mmartinbr/coil-winder/images-videos/coil-winder/IMG_20200219_183628.jpg

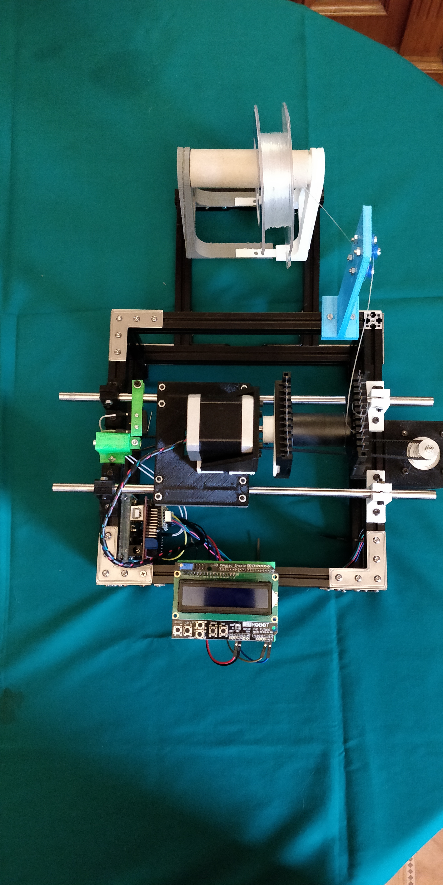
images-videos/coil-winder/IMG_20200219_183628.jpg
