mmartinbr/coil-winder/images-videos/coil-winder/IMG_20200219_183638.jpg

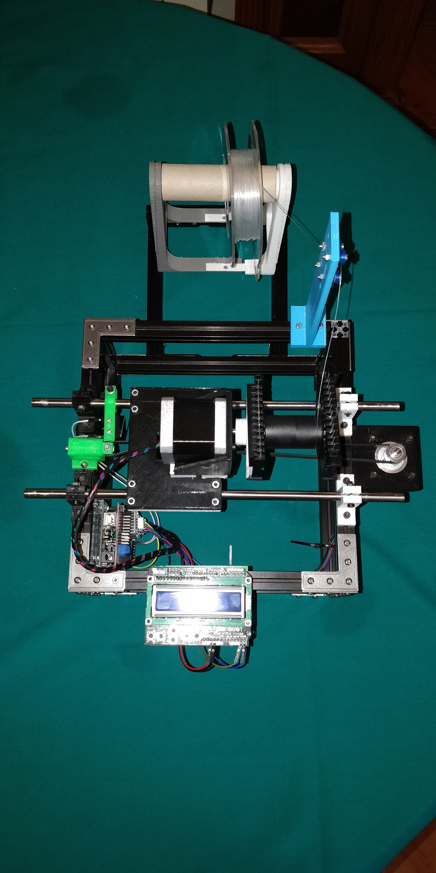
images-videos/coil-winder/IMG_20200219_183638.jpg
