mmartinbr/coil-winder/images-videos/coil-winder/IMG_20200219_184023.jpg

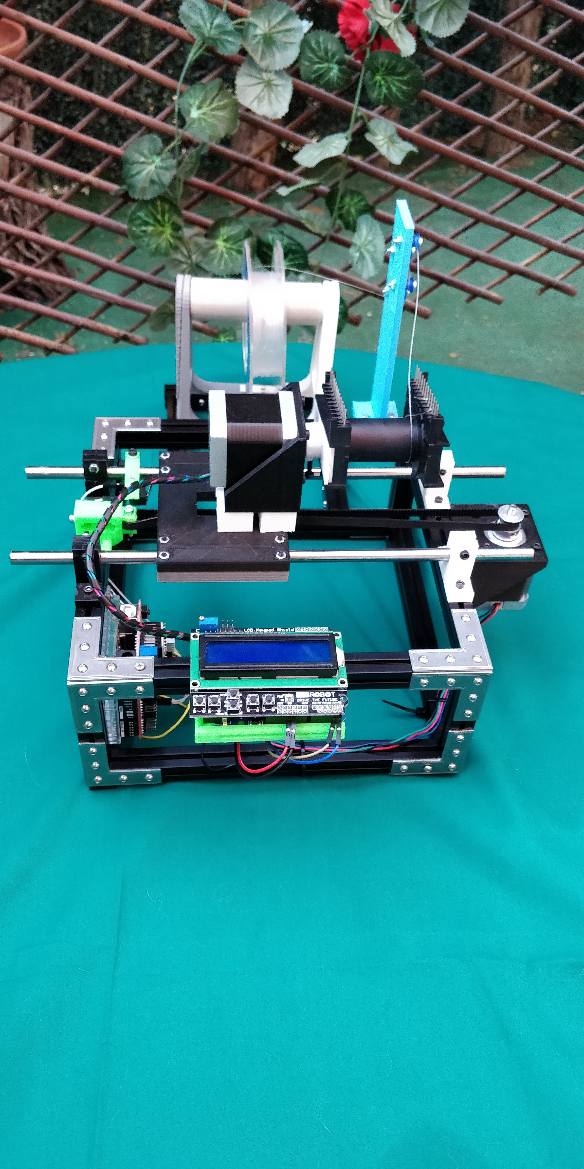
images-videos/coil-winder/IMG_20200219_184023.jpg
