mmartinbr/coil-winder/images-videos/coil-winder/IMG_20200219_184037.jpg

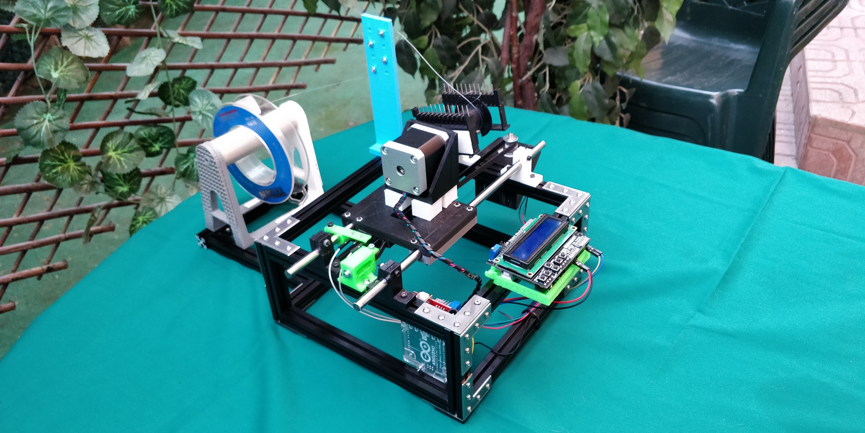
images-videos/coil-winder/IMG_20200219_184037.jpg
