mmartinbr/coil-winder/images-videos/coil-winder/IMG_20200219_184148.jpg

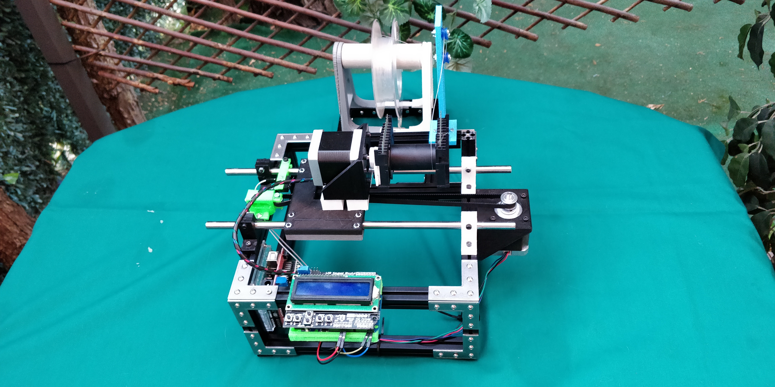
images-videos/coil-winder/IMG_20200219_184148.jpg
