mmartinbr/coil-winder/images-videos/i2c-communication/IMG_20200202_224621.jpg

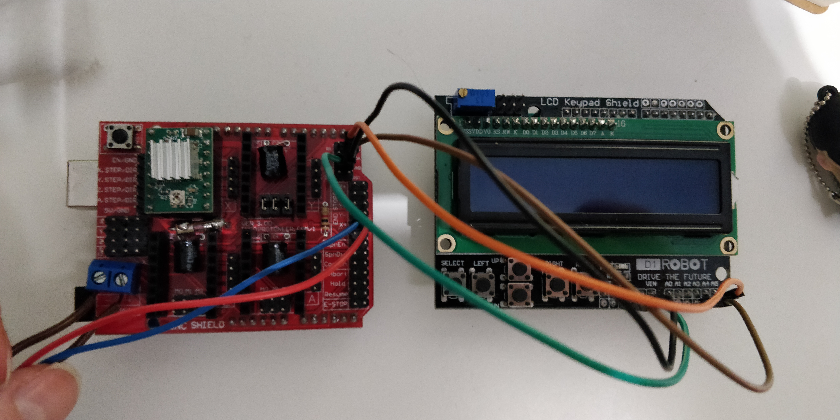
images-videos/i2c-communication/IMG_20200202_224621.jpg
