mmartinbr/coil-winder/images-videos/IMG_20200218_215349.jpg

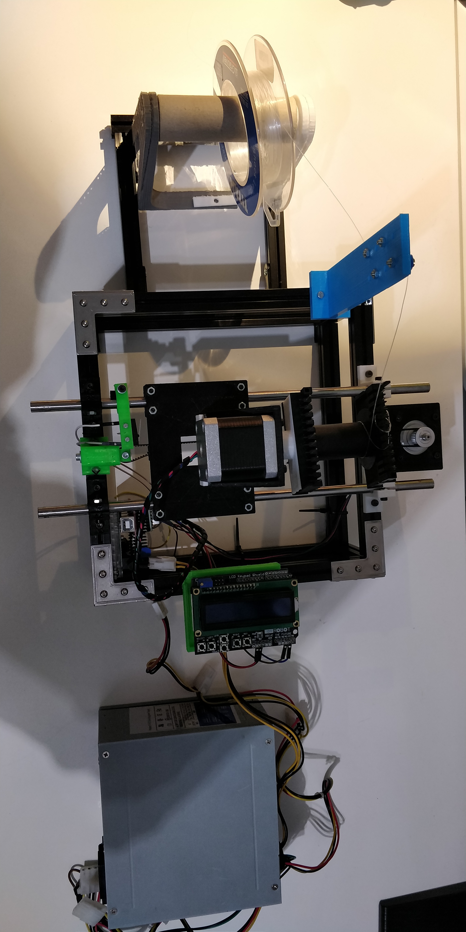
images-videos/IMG_20200218_215349.jpg
