mmartinbr/coil-winder/images-videos/IMG_20200218_215355.jpg

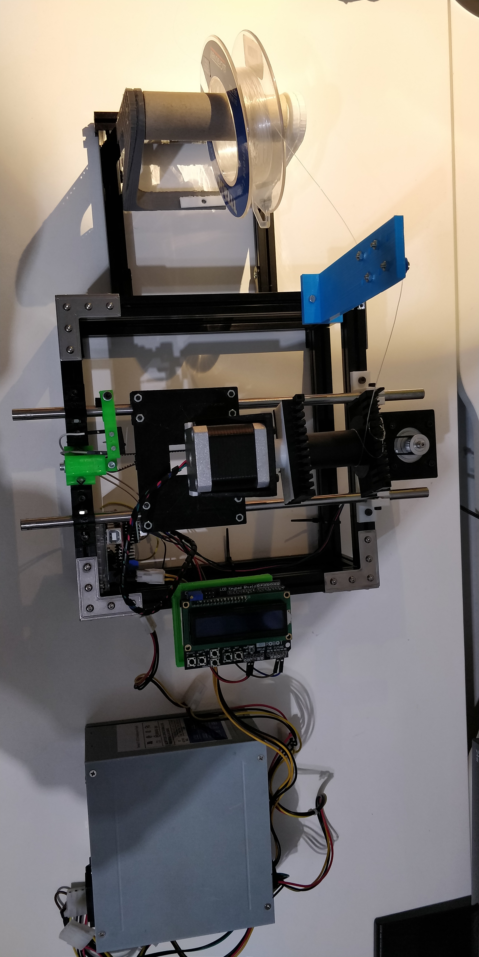
images-videos/IMG_20200218_215355.jpg
