mmartinbr/coil-winder/images-videos/IMG_20200218_215358.jpg

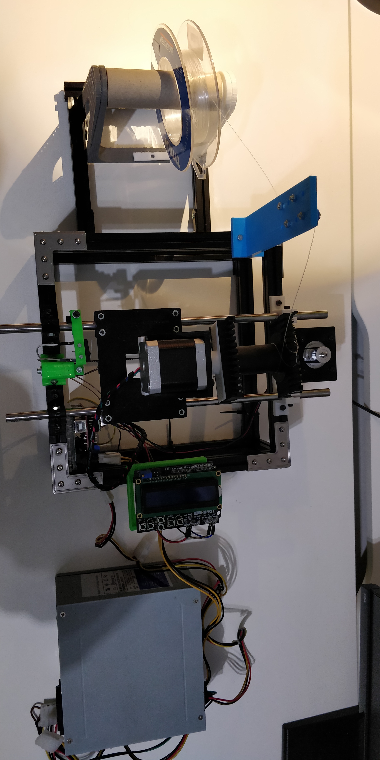
images-videos/IMG_20200218_215358.jpg
