mmartinbr/coil-winder/images-videos/IMG_20200218_215542.jpg

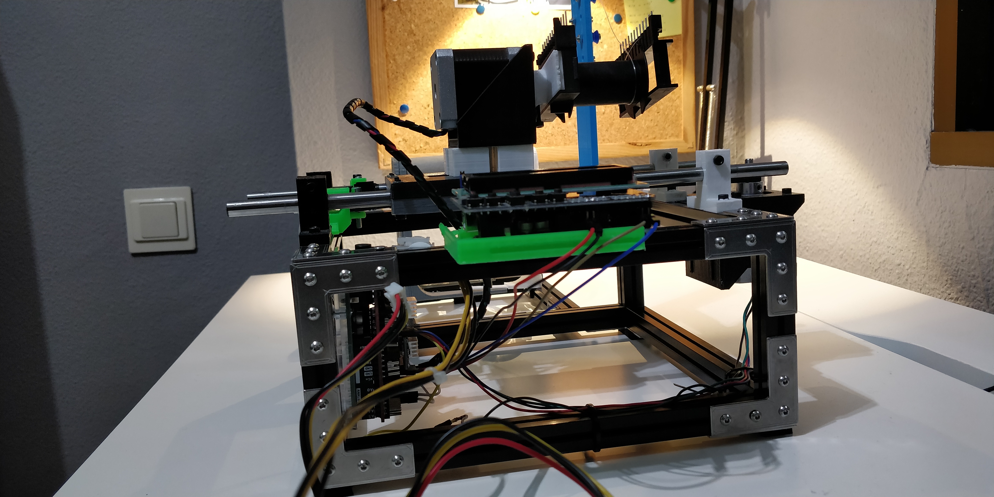
images-videos/IMG_20200218_215542.jpg
