mmartinbr/coil-winder/images-videos/IMG_20200218_215630.jpg

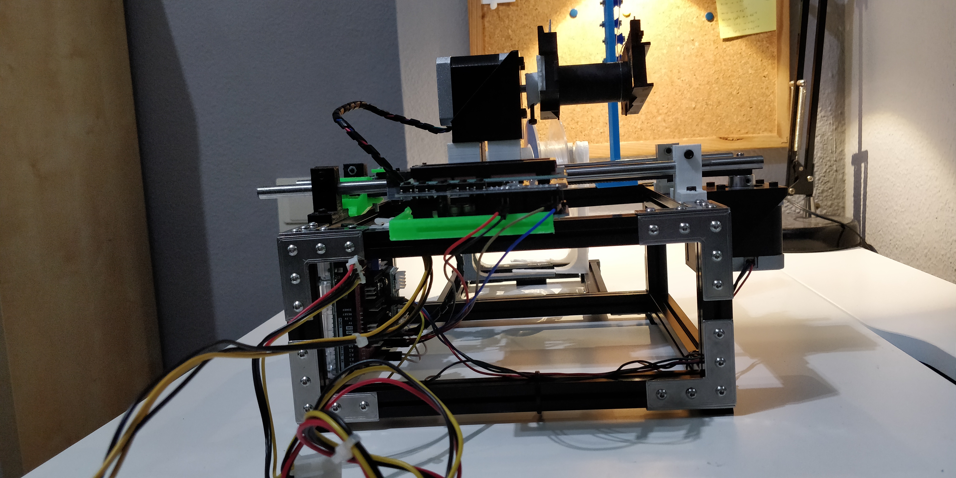
images-videos/IMG_20200218_215630.jpg
