mmartinbr/coil-winder/images-videos/IMG_20200218_215646.jpg

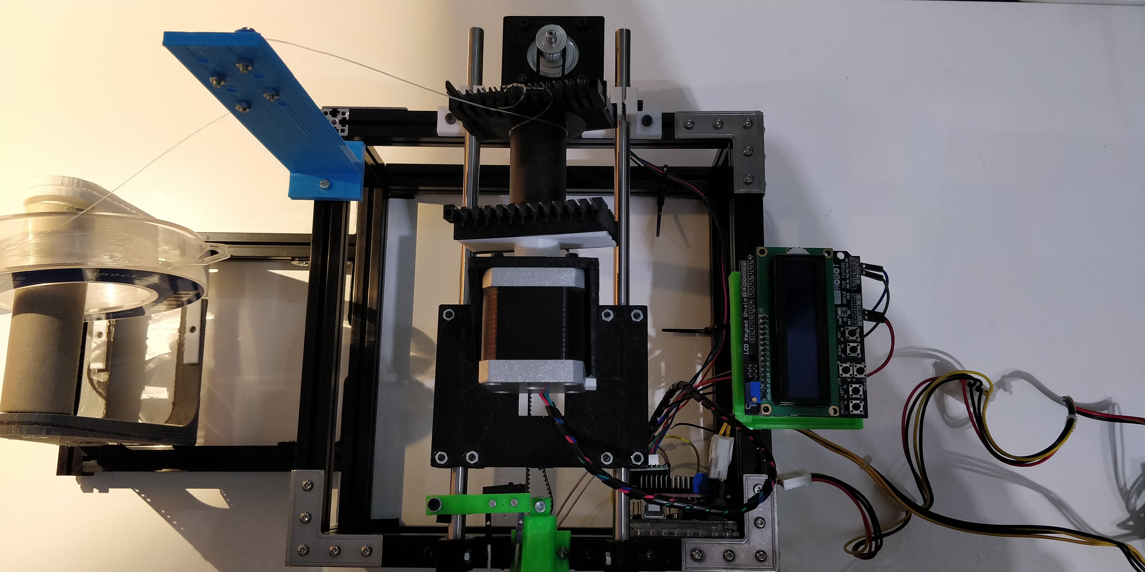
images-videos/IMG_20200218_215646.jpg
