mmartinbr/coil-winder/images-videos/IMG_20200218_215827.jpg

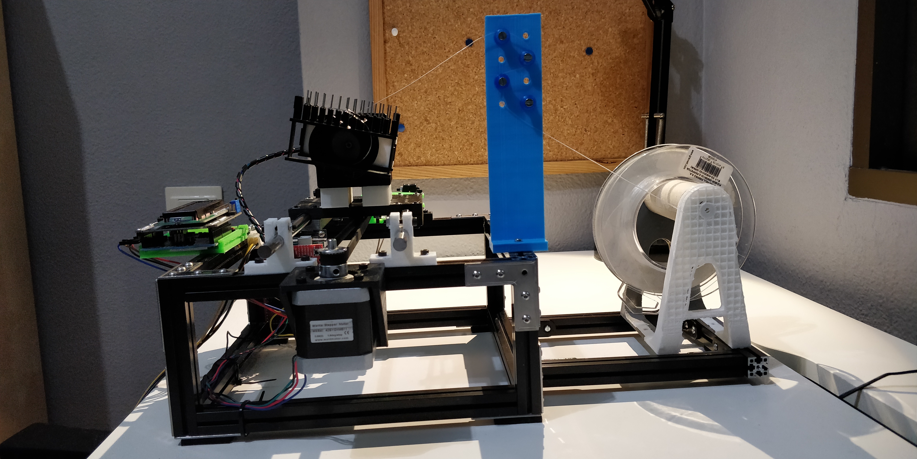
images-videos/IMG_20200218_215827.jpg
