mmartinbr/coil-winder/images-videos/IMG_20200218_215900.jpg

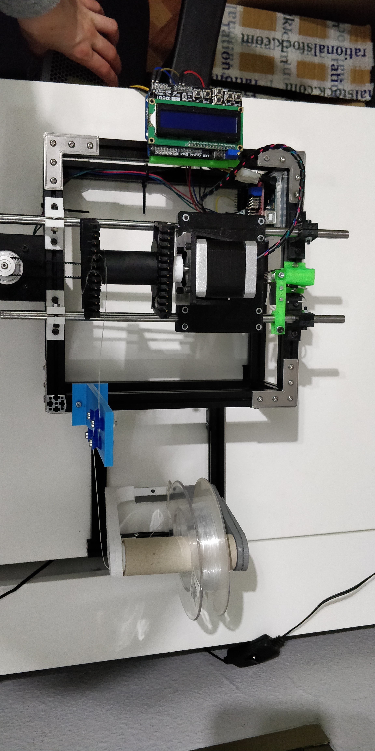
images-videos/IMG_20200218_215900.jpg
