mmartinbr/coil-winder/images-videos/lcd-display/IMG_20200202_213406.jpg

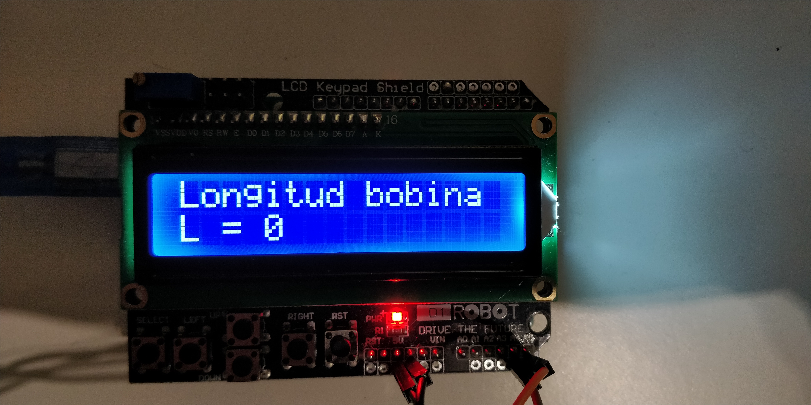
images-videos/lcd-display/IMG_20200202_213406.jpg
