mmartinbr/coil-winder/documentation/components/coil-winder-bom.xlsx

Sheet: Elementos_comprados
Componente | Cantidad | Proveedor | Precio unitario | Precio total | Enlace
Correa dentada GT2 - 6mm - 1m | 1 | HTA3D | 1.37 € | 1.37 € | https://www.hta3d.com/es/correa-dentada-gt2-6mm-1m
Polea GT2 - 20 dientes | 2 | HTA3D | 1.10 € | 2.20 € | https://www.hta3d.com/componentes/mecanica/correas-y-poleas/polea-gt2-20-dientes
Motor paso a paso Nema 17, Serie 17HS 17HS8401 | 2 | HTA3D | 12.85 € | 25.70 € | https://www.hta3d.com/componentes/electronica/motor-paso-a-paso/nema17-motor-paso-a-paso-serie-17hs-motor-paso-a-paso-hibrido-dos-fases
Ejes - Varilla lisa calibrada diámetro 8 | 2 | HTA3D | 2.65 € | 5.30 € | https://www.hta3d.com/componentes/mecanica/movimiento-lineal/varilla-lisa-calibrada-diametro-8-cortada-a-medida
Rodamiento lineal Lm8uu | 4 | HTA3D | 0.58 € | 2.32 € | https://www.hta3d.com/rodamiento-lineal-lm8uu
Placa Arduino UNO | 2 | FARNELL | 19.49 € | 38.98 € | http://es.farnell.com/arduino/a000066/atmega328-arduino-uno-eval-board/dp/2075382?ICID=I-HP-PP-Arduino-A000066
Arduino CNC Shield V3.51 | 1 | 3DSMART | 8.29 € | 8.29 € | http://www.3dsmart.es/impresora-3d/electronica/placa-ramps-14.html
POLOLU A4988 | 2 | ELECTRONICA EMBAJADORES | 7.11 € | 14.22 € | https://www.electronicaembajadores.com/es/Productos/Detalle/LCMM004/modulos-electronicos/modulos-driver-y-o-controladores-de-motores/driver-motores-paso-a-pas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
Carcasa Arduino UNO | 2 | AMAZON | 4.30 € | 8.60 € | https://www.amazon.es/Premium-transparente-carcasa-Leonardo-Ethernet/dp/B078326ZDC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
LCD Keypad Shield | 1 | AMAZON | 9.99 € | 9.99 € | https://www.amazon.es/HALJIA%C2%AE-Display-Keyboard-Arduino-MEGA2560/dp/B06XDNY7FY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
Fuente de alimentación 500W ATX | 1 | AMAZON | 10.70 € | 10.70 € | https://www.amazon.es/Unyka-Fuente-ALIMENTACION-500W-52099/dp/B07JBX6Q7B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
Interruptor final de carrera | 1 | CETRONIC | 5.37 € | 10.74 € | https://www.cetronic.es/sqlcommerce/disenos/plantilla1/seccion/Catalogo.jsp?idIdioma=&idTienda=93&cPath=1160
4 barras de 200mm | 2 | MAKERBEAM | 9.25 € | 18.50 € | https://www.makerbeam.com/200mm-4p-black-makerbeamxl-15mmx15mm.html
4 barras de 100mm | 1 | MAKERBEAM | 5.00 € | 5.00 € | https://www.makerbeam.com/100mm-4p-black-makerbeamxl-15mmx15mm.html
4 barras de 100mm | 1 | MAKERBEAM | 5.00 € | 5.00 € | https://www.makerbeam.com/150mm-4p-clear-makerbeamxl-15mmx15mm.html
100 tornillos, M3, 6mm | 1 | MAKERBEAM | 6.50 € | 6.50 € | https://www.makerbeam.com/openbeam-button-head-socket-bolt-6mm-100p-for-open.html
250 tuercas, M3 | 1 | MAKERBEAM | 4.50 € | 4.50 € | https://www.makerbeam.com/makerbeam-nuts-regular-250p.html
12 Escuadras MakerBeam | 2 | MAKERBEAM | 6.95 € | 13.90 € | https://www.makerbeam.com/makerbeam-right-angle-brackets-12p.html
Filamento PLA | 0.7 | HTA3D | 13.50 € | 9.45 € | https://www.hta3d.com/es/bobina-filamento-pla-3d-1-75mm-1kg
Total |  |  |  | 201.26 €

Sheet: Elementos_impresos_en_3D
Pieza | Unidades
Soporte de la bobina | 1
Carcasas | 2
Soporte de los ejes | 4
Soporte de los motores | 2
Soporte del final de carrera
Soporte de la correa
