mmartinbr/coil-winder/freecad-components/rodamientos-soporte-ejes.FCStd

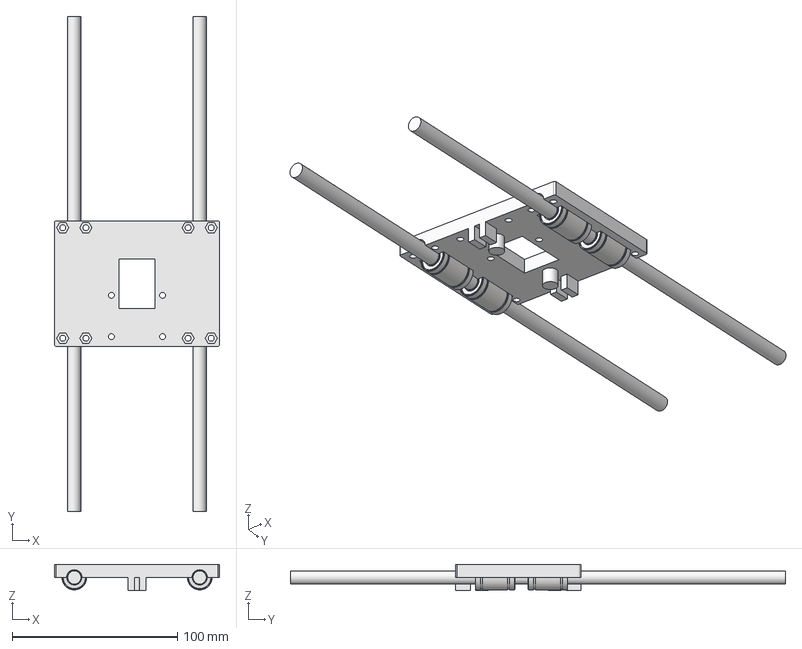
[picture p85: CAD file, 2020-02-20]
freecad-components/rodamientos-soporte-ejes.FCStd
100.0 x 300.0 x 16.0 mm
Lm8uu
Lm8uu001
Lm8uu002
Lm8uu003
Eje1
Eje002
