mmartinbr/coil-winder/freecad-components/tobetested/Cilindros modulo tensionador.FCStd

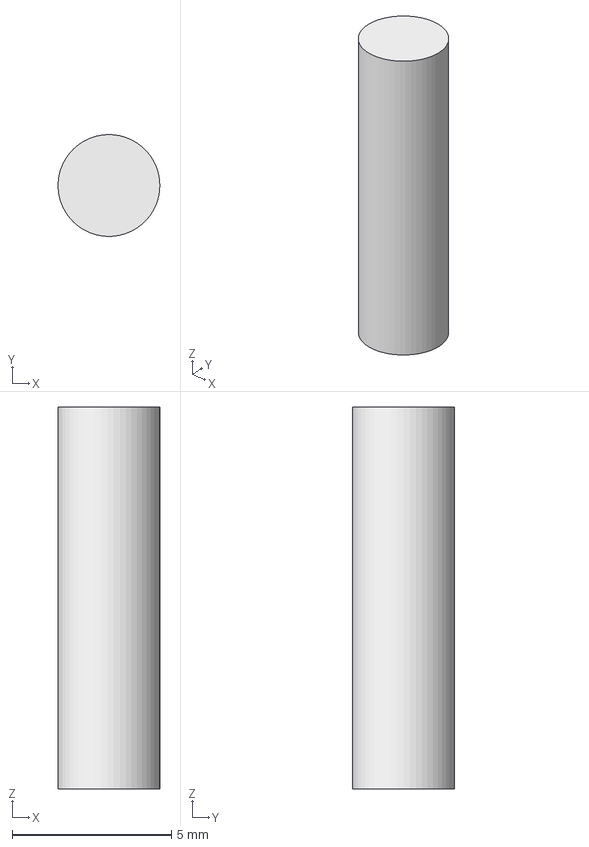
[picture p86: CAD file, 2020-01-19]
freecad-components/tobetested/Cilindros modulo tensionador.FCStd
3.20 x 3.20 x 12.0 mm
