mmartinbr/coil-winder/freecad-components/Soporte bobina-eje_v2.stl

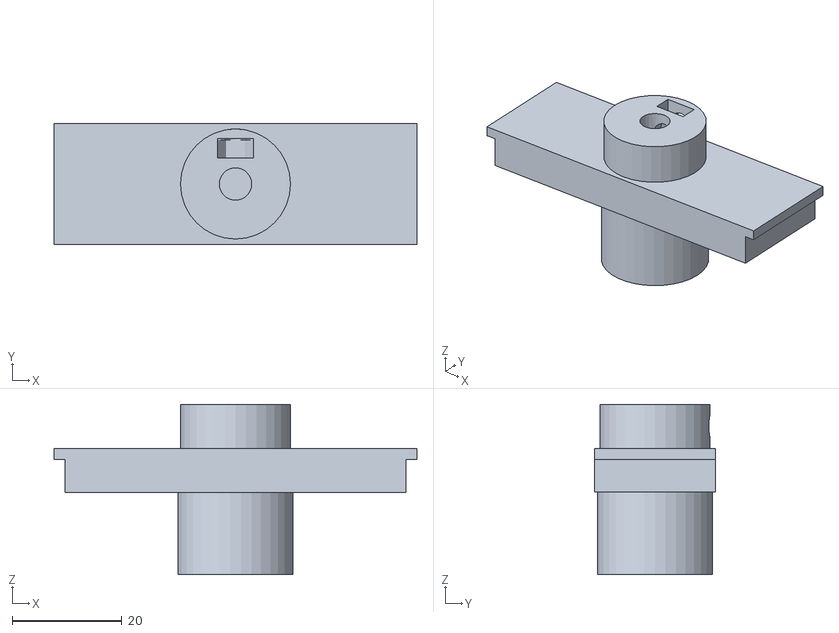
[picture p87: CAD file, 2020-02-18]
freecad-components/Soporte bobina-eje_v2.stl
66.0 x 22.0 x 31.0
