mmartinbr/coil-winder/freecad-components/tobetested/Exterior cilindros modulo tensionador.FCStd

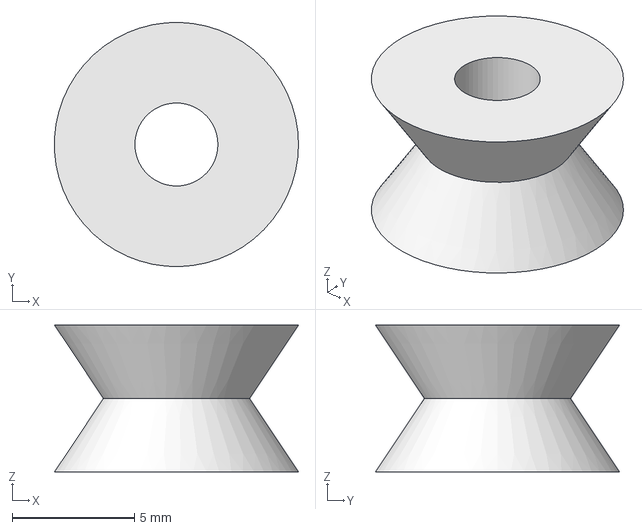
[picture p88: CAD file, 2019-09-13]
freecad-components/tobetested/Exterior cilindros modulo tensionador.FCStd
9.99 x 10.00 x 6.00 mm
