mmartinbr/coil-winder/freecad-components/Soporte bobina-eje.FCStd

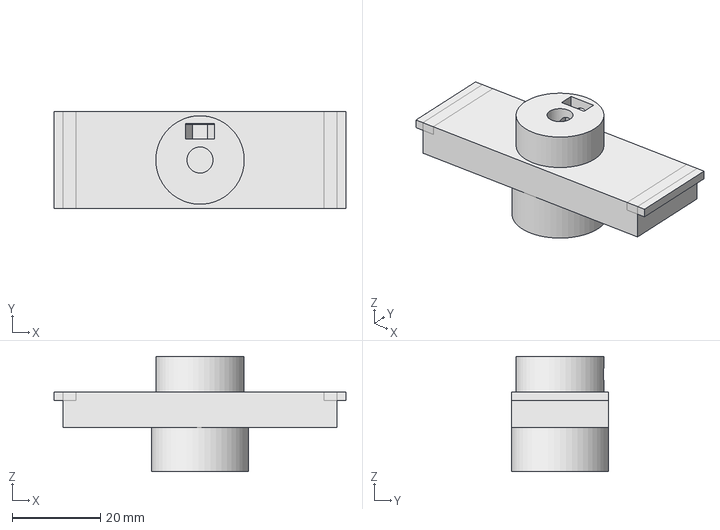
[picture p89: CAD file, 2020-02-18]
freecad-components/Soporte bobina-eje.FCStd
66.0 x 22.0 x 26.0 mm
