mmartinbr/coil-winder/freecad-components/tobetested/Prueba taladro módulo tensionador.FCStd

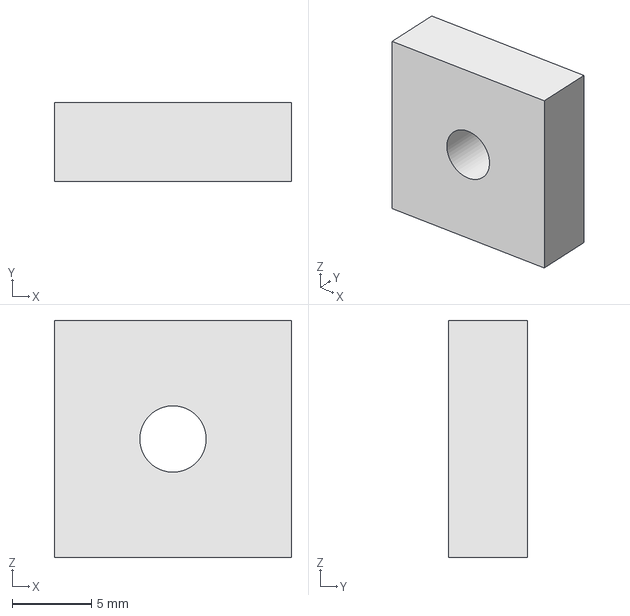
[picture p90: CAD file, 2019-09-10]
freecad-components/tobetested/Prueba taladro módulo tensionador.FCStd
15.0 x 5.00 x 15.0 mm
