mmartinbr/coil-winder/freecad-components/Conjunto módulo tensionador.FCStd

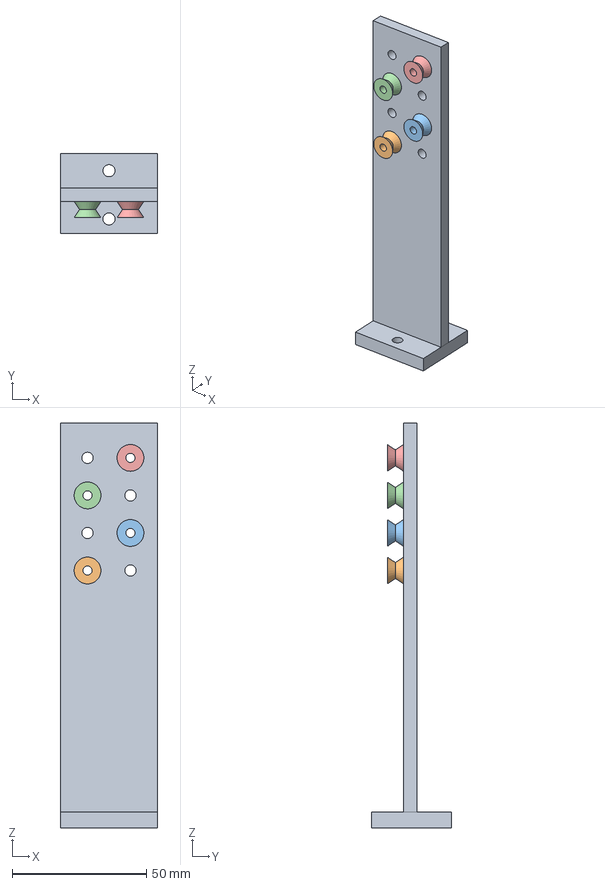
[picture p91: CAD file, 2020-02-01]
freecad-components/Conjunto módulo tensionador.FCStd
36.0 x 30.0 x 151.0 mm
modulo-tensionador2
tensioner
tensioner001
tensioner002
tensioner003
