mmartinbr/coil-winder/freecad-components/modulo_tensionador2.stl

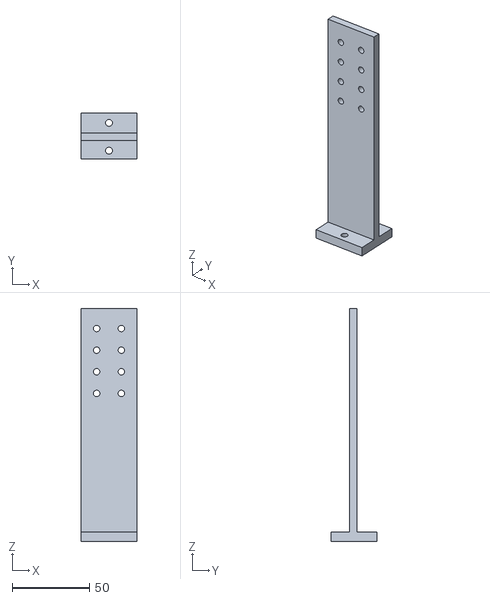
[picture p92: CAD file, 2020-01-19]
freecad-components/modulo_tensionador2.stl
36.0 x 30.0 x 151.0
