mmartinbr/coil-winder/freecad-components/exterior_cilindro2.stl

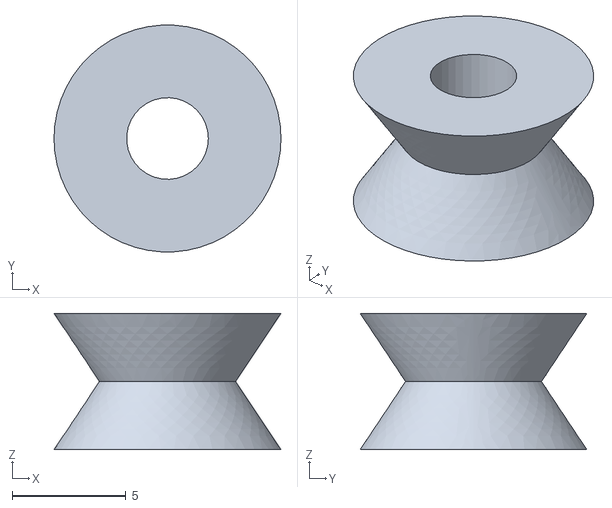
[picture p93: CAD file, 2020-01-19]
freecad-components/exterior_cilindro2.stl
10.0 x 9.98 x 6.00
