mmartinbr/coil-winder/freecad-components/modulo_tensionador.stl

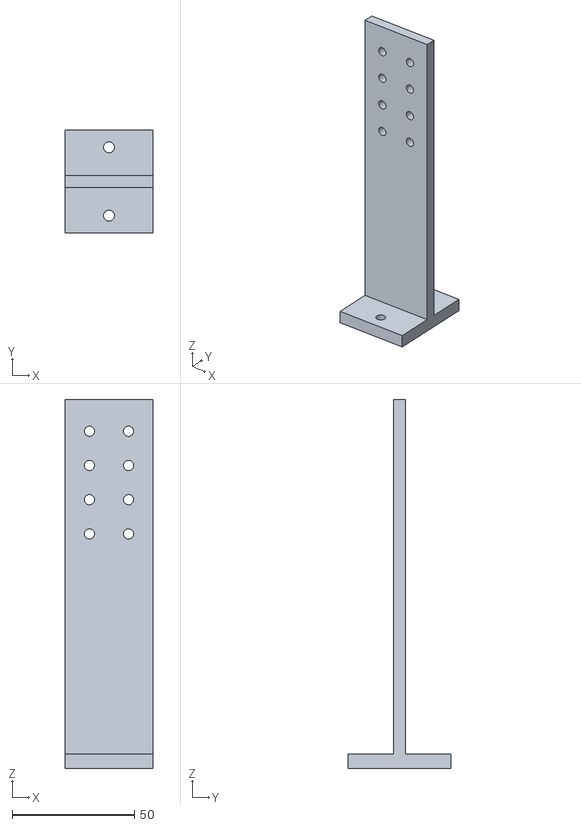
[picture p94: CAD file, 2020-01-19]
freecad-components/modulo_tensionador.stl
36.0 x 42.0 x 151.0
