mmartinbr/coil-winder/freecad-components/Soporte eje Marta.FCStd

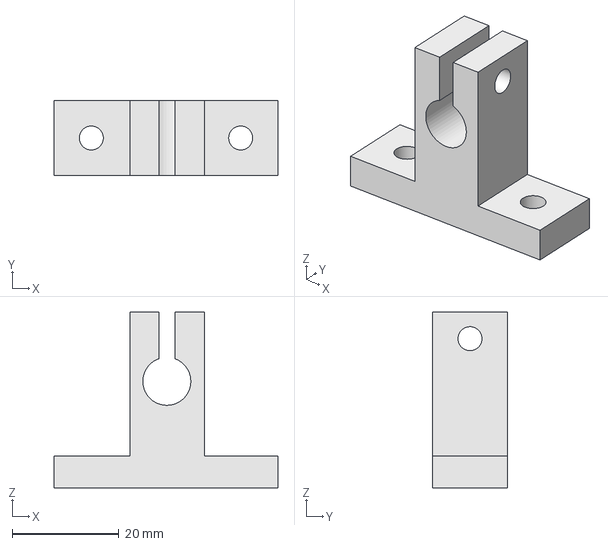
[picture p95: CAD file, 2019-09-10]
freecad-components/Soporte eje Marta.FCStd
42.0 x 14.0 x 33.0 mm
