mmartinbr/coil-winder/freecad-components/Tacos alza.FCStd

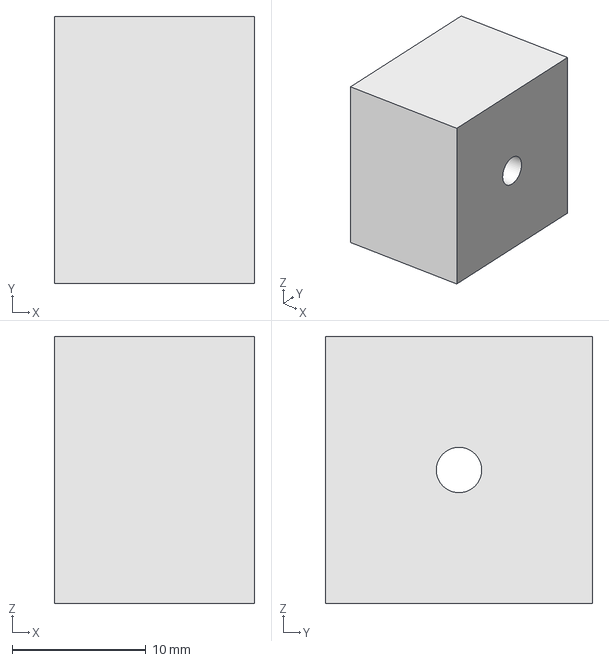
[picture p96: CAD file, 2019-09-10]
freecad-components/Tacos alza.FCStd
15.0 x 20.0 x 20.0 mm
