mmartinbr/coil-winder/freecad-components/Soporte final de carrera.FCStd

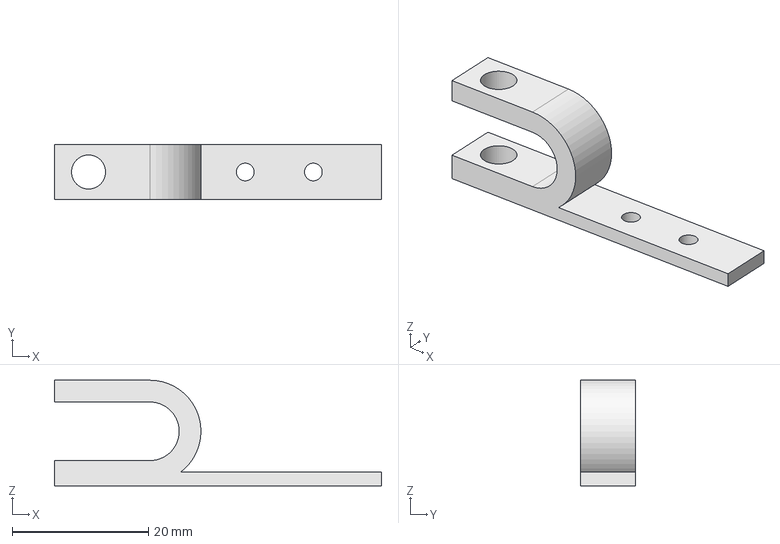
[picture p97: CAD file, 2019-09-10]
freecad-components/Soporte final de carrera.FCStd
48.0 x 8.00 x 15.5 mm
