mmartinbr/coil-winder/freecad-components/Carcasa 2.FCStd

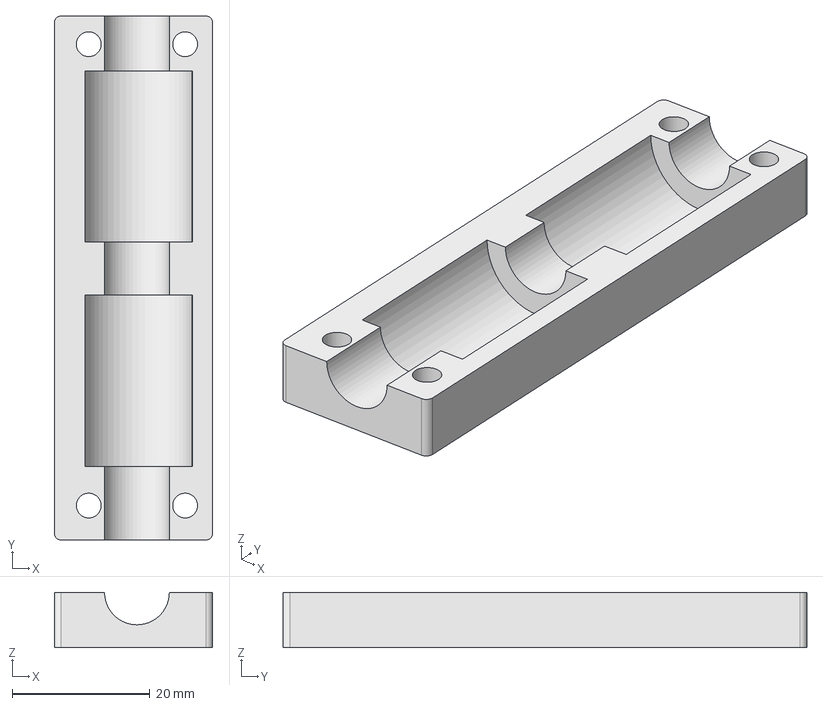
[picture p98: CAD file, 2019-09-10]
freecad-components/Carcasa 2.FCStd
23.0 x 76.1 x 8.00 mm
