mmartinbr/coil-winder/freecad-components/Nema holder.FCStd

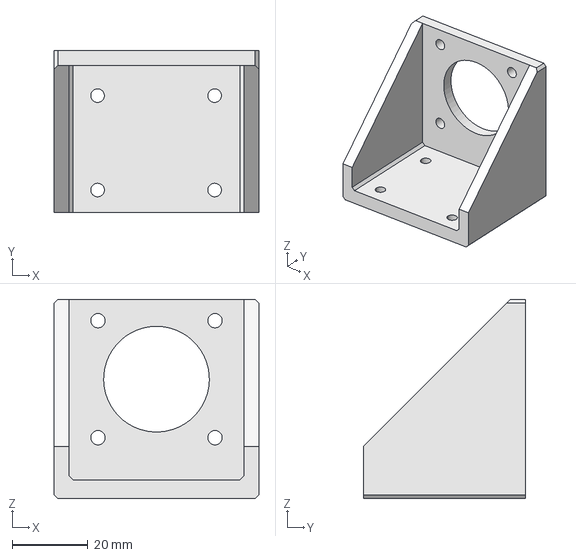
[picture p99: CAD file, 2019-09-10]
freecad-components/Nema holder.FCStd
54.3 x 43.0 x 52.8 mm
