mmartinbr/coil-winder/freecad-components/Coil winder.FCStd

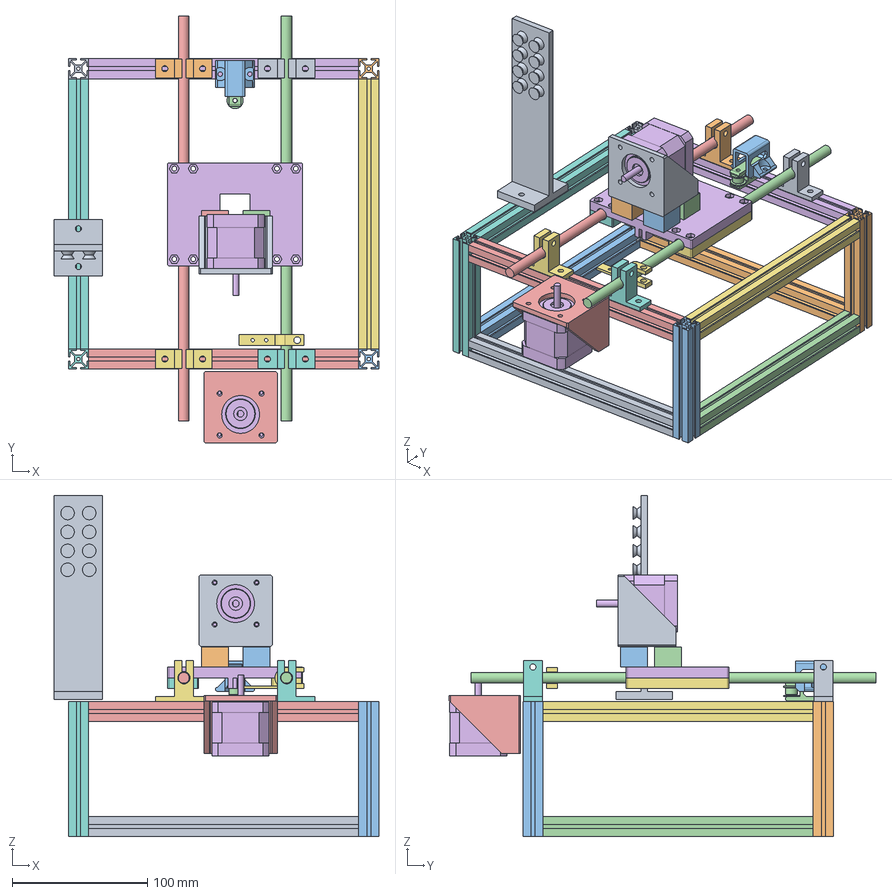
[picture p100: CAD file, 2019-09-10]
freecad-components/Coil winder.FCStd
240.5 x 316.1 x 252.5 mm
aluprof_w15l_200
aluprof_w15l_201
aluprof_w15l_202
aluprof_w15l_203
aluprof_w15l_205
aluprof_w15l_206
aluprof_w15l_204
aluprof_w15l_100
aluprof_w15l_208
aluprof_w15l_209
aluprof_w15l_210
Eje1
Eje002
Soporte principal VII
Carcasa 1 VI
Carcasa 2 VI
nema holder modificados taladros
Nema-17-motor-40mm-final
Soporte eje
Soporte eje001
Soporte eje002
Soporte eje003
tensioner_holder
idler_tensioner_set
nema holder modificados taladros001
Nema-17-motor-40mm-final001
Soporte finalcarrera
aluprof_w15l_207
