mmartinbr/coil-winder/freecad-components/Estructura.FCStd

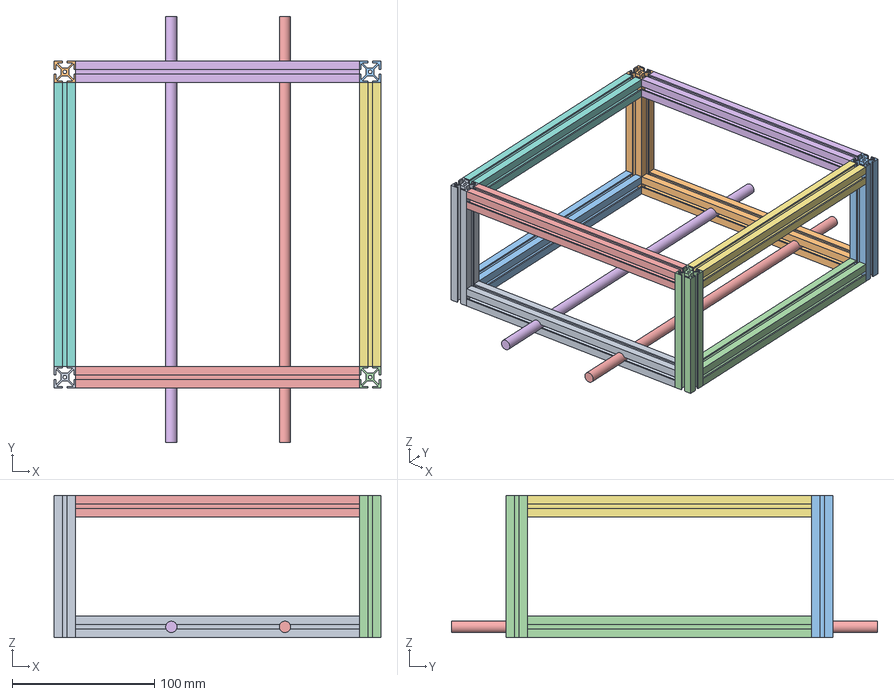
[picture p101: CAD file, 2019-09-10]
freecad-components/Estructura.FCStd
230.0 x 300.0 x 100.0 mm
aluprof_w15l_200
aluprof_w15l_201
aluprof_w15l_202
aluprof_w15l_203
aluprof_w15l_205
aluprof_w15l_206
aluprof_w15l_204
aluprof_w15l_207
aluprof_w15l_100
aluprof_w15l_208
aluprof_w15l_209
aluprof_w15l_210
Eje1
Eje002
