mmartinbr/coil-winder/freecad-components/Soporte principal.FCStd

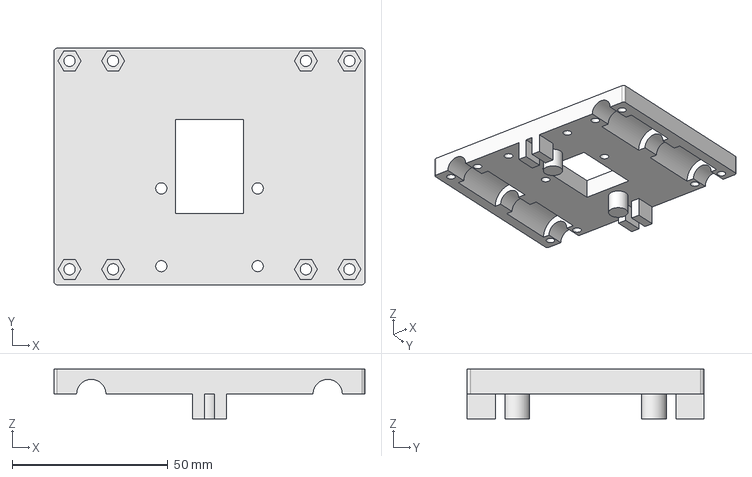
[picture p102: CAD file, 2019-09-10]
freecad-components/Soporte principal.FCStd
100.0 x 76.1 x 16.0 mm
