mmartinbr/coil-winder/(list of files, cad)

Other CAD files:
freecad-components/exterior_cilindros.stl
freecad-components/prueba_taladro.stl
freecad-components/cilindros.stl
freecad-components/Carcasa 1.FCStd
freecad-components/Soporte bobina-eje.stl
