mmartinbr/coil-winder/arduino-code/trials/Coil_winder_sixteenthstep/Coil_winder_sixteenthstep.ino

// Ponemos nombre al motor, el número de pasos y los pins de control
//Stepper stepper(STEPS, 2, 5); //Stepper nombre motor (número de pasos por vuelta, pins de control)
int step_x = 2;
int dir_x = 5;
int enable = 8;
int step_y = 3;
int dir_y = 6;
int endstop_x = 9;
int value = 0;
int t = 0.05;

//Definimos las características del la bobina que queremos devanar:
float L = 40; //Longitud de la bobina a devanar, en mm
float d = 0.5; //Diámetro del hilo de cobre, en mm
int a = L / d; //Nº de vueltas que hay que girar por capa
int o = (16 * d) / 0.2;
int N = 6;


void setup() {

  pinMode(enable, OUTPUT);
  pinMode(dir_x, OUTPUT);
  pinMode(step_x, OUTPUT);
  pinMode(dir_y, OUTPUT);
  pinMode(step_y, OUTPUT);

}

void loop() {

  for (int z = 0; z < a; z++) {

    //Slider de o en o
    for (int k = 1; k < 100; k++) {

      digitalWrite(dir_x, HIGH);
      delay(1); //Pequeña pausa
      digitalWrite(step_x, HIGH);
      delay(0.05); //Pequeña pausa
      digitalWrite(step_x, LOW);
      delay(0.05); //Pequeña pausa
      z = z + 1;

      //Winder de 3200 en 3200 (micro steps *16)
      for (int m = 1; m < 3200; m++) {
        digitalWrite(dir_y, LOW);
        delay(1); //Pequeña pausa
        digitalWrite(step_y, HIGH);
        delay(t); //Pequeña pausa
        digitalWrite(step_y, LOW);
        delay(t); //Pequeña pausa
      }
    }
  }
}
