mmartinbr/coil-winder/(commit log)

2019-09-10 added new files to the project
    [Carcasa 1.FCStd, Carcasa 2.FCStd, Coil winder.FCStd, Conjunto módulo tensionador.FCStd, Estructura.FCStd, Nema holder.FCStd, Prueba cilindros modulo tensionador.FCStd, Prueba taladro módulo tensionador.FCStd]
2019-09-13 changed tensioner component
    [Prueba cilindros modulo tensionador.FCStd]
2020-01-19 Changes in code and documentation
    [Cilindros modulo tensionador.FCStd, Conjunto módulo tensionador.FCStd, Exterior cilindros modulo tensionador.FCStd, Prueba cilindros modulo tensionador.FCStd, cilindros.stl, exterior_cilindro2.stl, exterior_cilindros.stl, modulo_tensionador.stl]
2020-02-01 added arduino-code for i2c communication between boards
    [Conjunto módulo tensionador.FCStd]
2020-02-08 updated documentation and added a list of materials
    [coil-winder-bom.xlsx]
2020-02-18 updated docs
    [Soporte bobina-eje.FCStd, Soporte bobina-eje.stl, Soporte bobina-eje_v2.stl, coil-winder-bom.xlsx]
2020-02-20 completed documentation
    [rodamientos-soporte-ejes.FCStd]
